uun3406/BLDC-TestBed-HardwareX/fig_system_overview.jpg

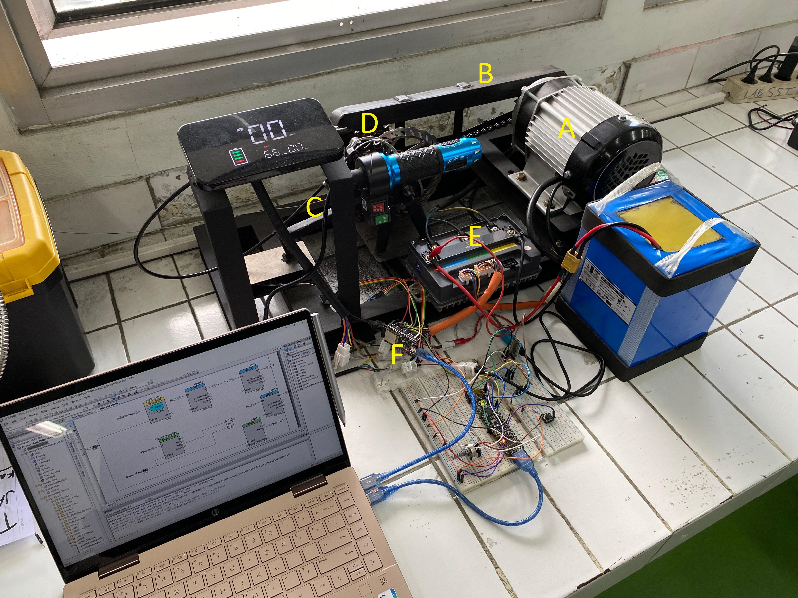
fig_system_overview.jpg
