uun3406/BLDC-TestBed-HardwareX/fig_mechanical_assembly.jpg

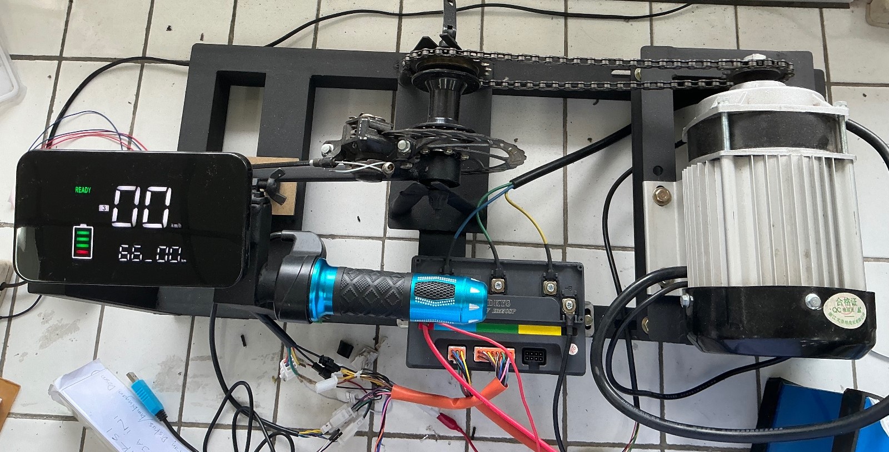
fig_mechanical_assembly.jpg
