uun3406/BLDC-TestBed-HardwareX/hardware/mechanical/frame_dimensions.pdf

# Frame Dimensions

Base frame for the BLDC motor test bed. The recommended base frame is 600 x 400 mm using 40 x 40 x 2 mm steel hollow sections. The motor mounting plate is 150 x 100 x 5 mm. The shaft center distance is 200 mm with a tolerance of +/- 0.5 mm.

This document summarizes the critical mechanical dimensions required for replication. Detailed assembly photos are available in hardware/mechanical/assembly_photos/.

Component | Dimension | Tolerance
Base frame | 600 x 400 mm | +/- 2 mm
Motor mounting plate | 150 x 100 x 5 mm | +/- 1 mm
Shaft center distance | 200 mm | +/- 0.5 mm
Brake disc runout | - | < 1 mm
