uun3406/BLDC-TestBed-HardwareX/hardware/mechanical/torque_arm_dimensions.pdf

# Torque Arm Dimensions

The torque arm is used to transfer floating-caliper reaction force to the load cell. The calibrated effective lever arm length is 100.0 mm. The arm is inclined at 40 degrees relative to the horizontal to accommodate the brake caliper geometry. Torque is calculated as T = F x L x cos(40 deg).

Parameter | Value | Tolerance/Note
Lever arm length | 100.0 mm | +/- 0.1 mm
Torque arm inclination | 40 degrees | +/- 1 degree
Load cell orientation | Vertical | Measure vertical reaction force
Torque equation | T = F x 0.1 x cos(40 deg) | T = F x 0.0766 m
