uun3406/BLDC-TestBed-HardwareX/hardware/wiring/esc_connector_pinout_table.pdf

# ESC Connector Pinout Reference Table

This table was redrawn from the supplied ESC connector image to improve readability. Verify row 5 of the 2 x 8 connector against the original ESC manual if exact wording is required.

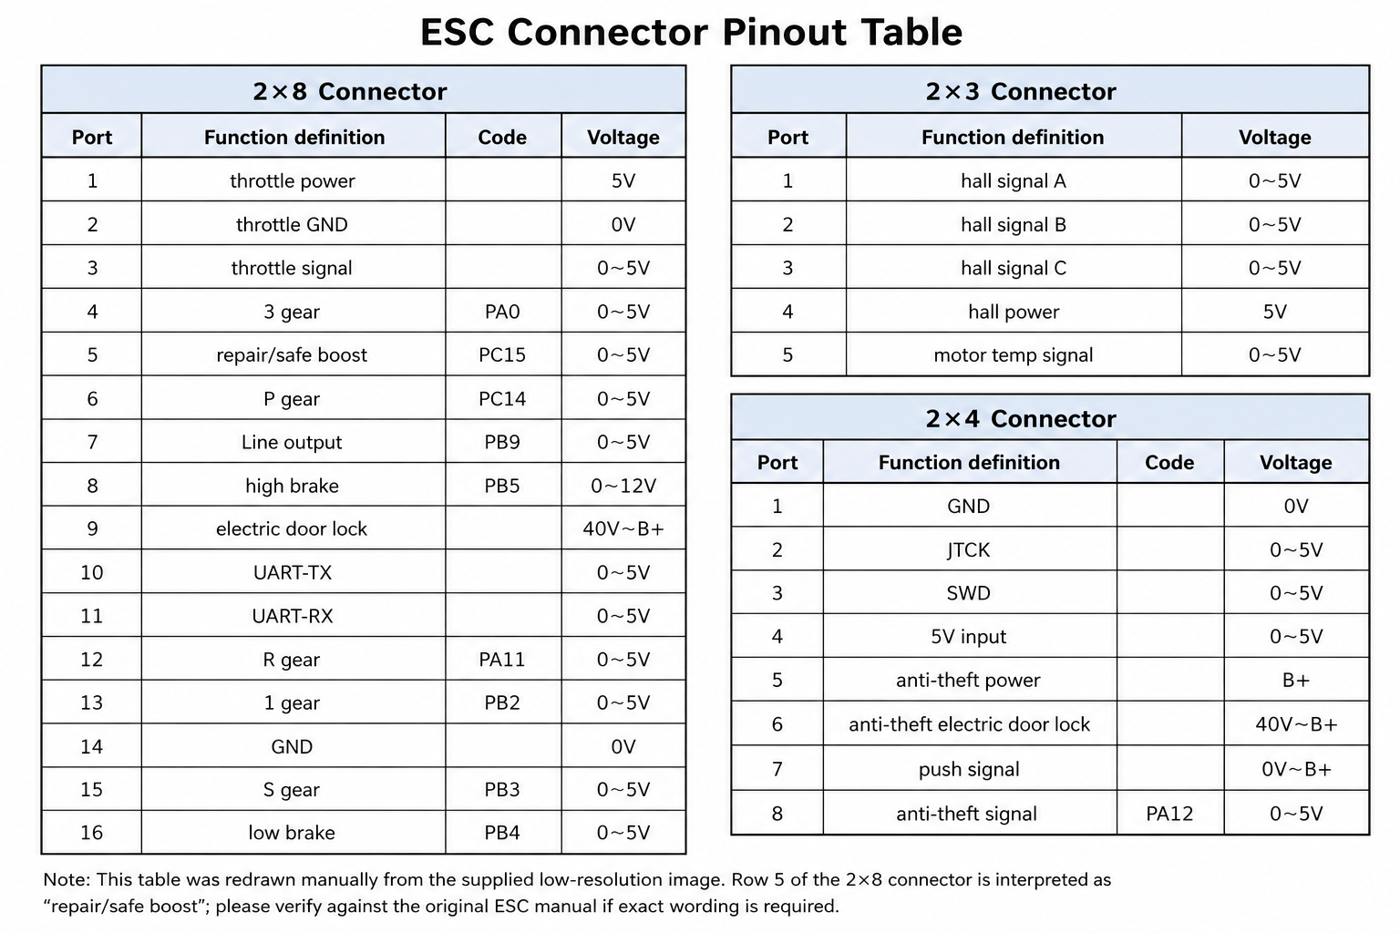
[picture p3: figure]
