uun3406/BLDC-TestBed-HardwareX/fig_floating_caliper.jpg

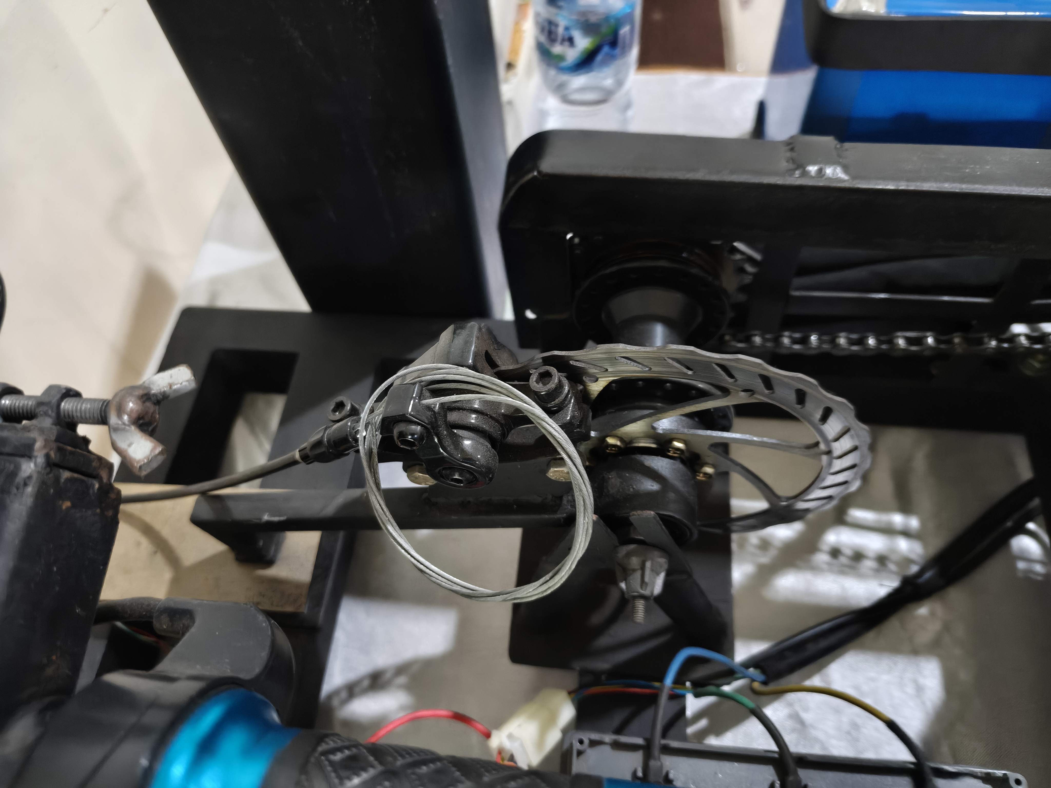
fig_floating_caliper.jpg
