uun3406/BLDC-TestBed-HardwareX/hardware/mechanical/assembly_photos/braking mechanics1.jpeg

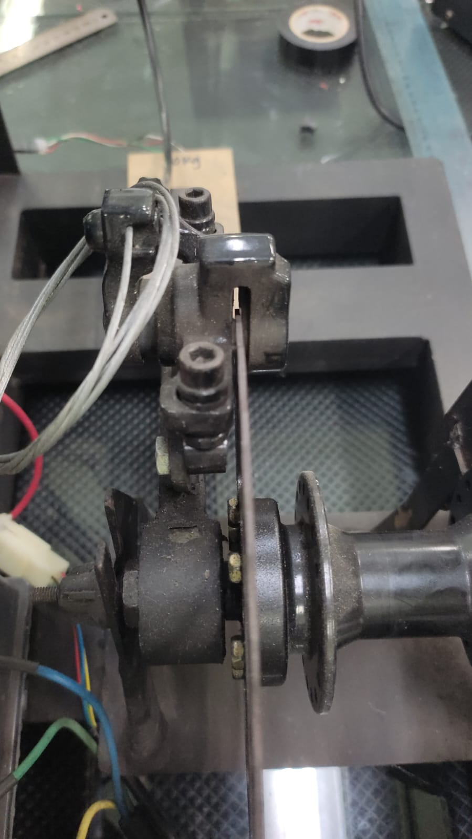
hardware/mechanical/assembly_photos/braking mechanics1.jpeg
