uun3406/BLDC-TestBed-HardwareX/hardware/mechanical/assembly_photos/braking mechanics2.jpeg

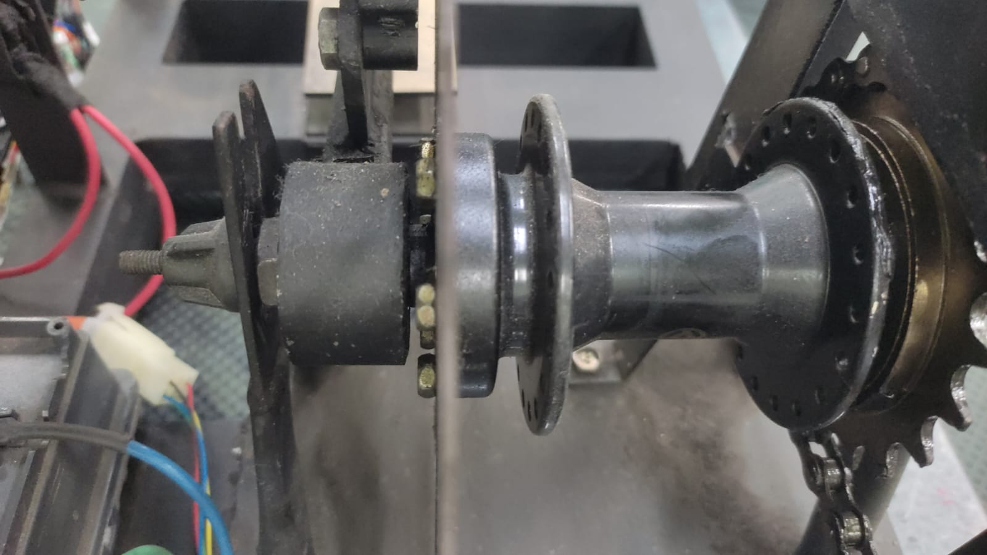
hardware/mechanical/assembly_photos/braking mechanics2.jpeg
