uun3406/BLDC-TestBed-HardwareX/hardware/mechanical/floating_caliper_photos/floating_caliper_mechanism.jpg

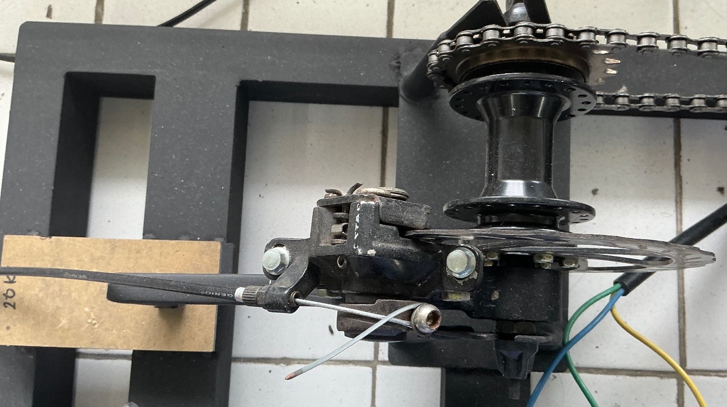
hardware/mechanical/floating_caliper_photos/floating_caliper_mechanism.jpg
