uun3406/BLDC-TestBed-HardwareX/hardware/mechanical/torque_arm_photo.jpg

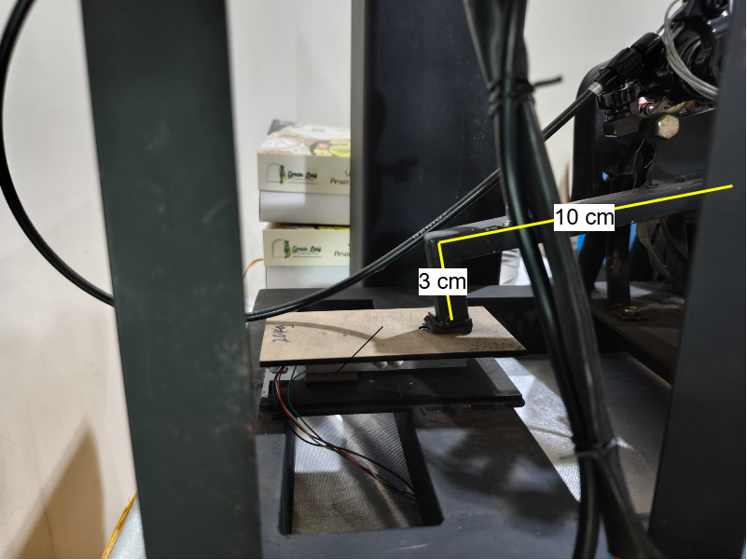
hardware/mechanical/torque_arm_photo.jpg
