uun3406/BLDC-TestBed-HardwareX/hardware/safety/emergency_stop_diagram.png

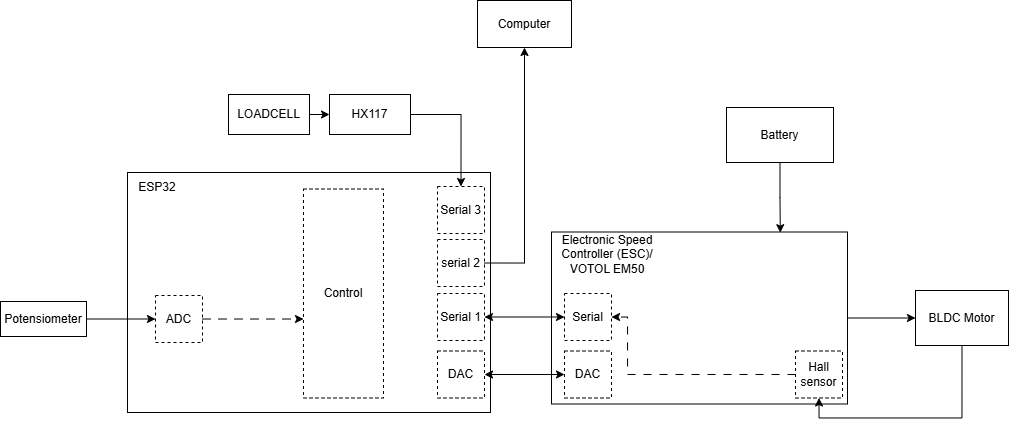
hardware/safety/emergency_stop_diagram.png
