uun3406/BLDC-TestBed-HardwareX/fig_bom_A_motor.jpg

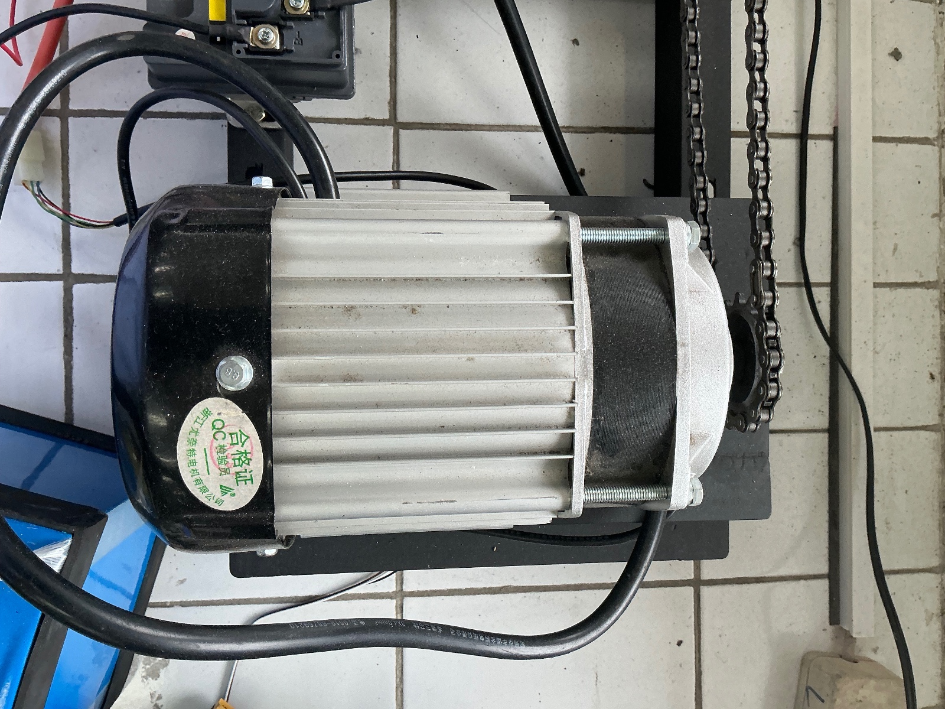
fig_bom_A_motor.jpg
