uun3406/BLDC-TestBed-HardwareX/fig_bom_B_esc.jpg

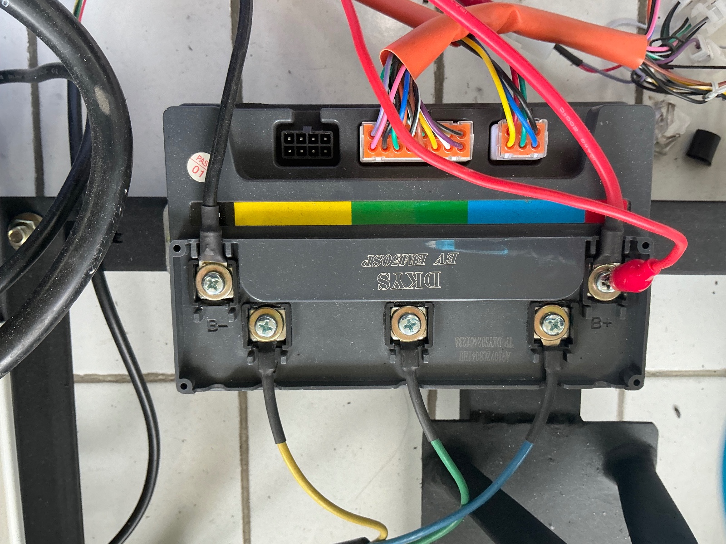
fig_bom_B_esc.jpg
