uun3406/BLDC-TestBed-HardwareX/fig_bom_C_esp32.jpg

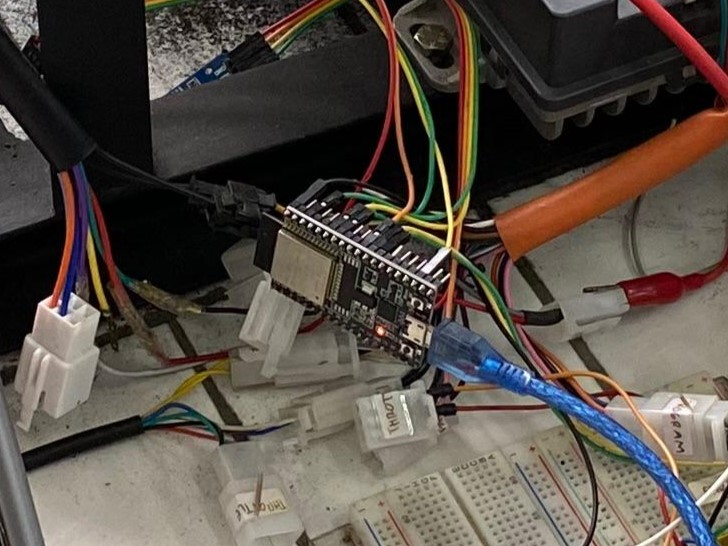
fig_bom_C_esp32.jpg
