uun3406/BLDC-TestBed-HardwareX/hardware/safety/pre_operation_checklist.pdf

# Pre-operation Checklist

Complete this checklist before every test session.

Check | Procedure | Acceptance
Mechanical fasteners | Torque check all bolts | No movement
Electrical insulation | Continuity test, 500 V megger | > 1 Mohm
Rotational freedom | Manual shaft rotation | Smooth, no binding
Chain guard | Verify complete installation | Fully enclosed
Emergency stop | Button press | Power interruption
Ground continuity | Resistance to earth | < 1 ohm
Battery safety | Check for damage/swelling | No defects
Torque arm angle | Measure with digital protractor | 40 deg +/- 1 deg
