uun3406/BLDC-TestBed-HardwareX/fig_operation_overview.jpg

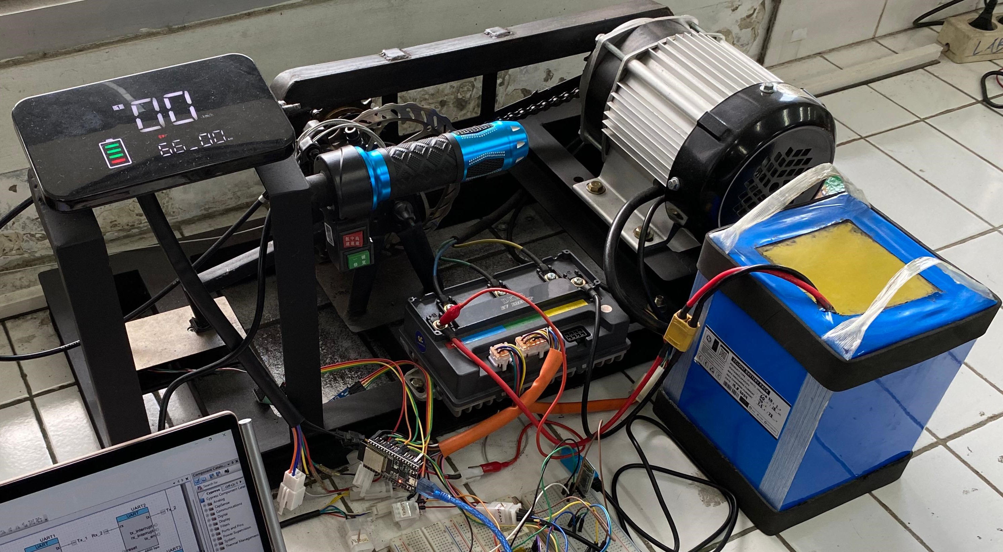
fig_operation_overview.jpg
