uun3406/BLDC-TestBed-HardwareX/hardware/mechanical/assembly_photos/BLDC Frame 1.jpeg

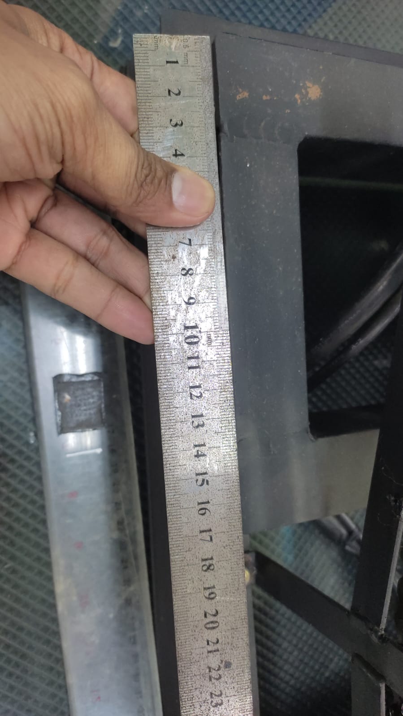
hardware/mechanical/assembly_photos/BLDC Frame 1.jpeg
