uun3406/BLDC-TestBed-HardwareX/hardware/mechanical/assembly_photos/brake adjuster thread.jpeg

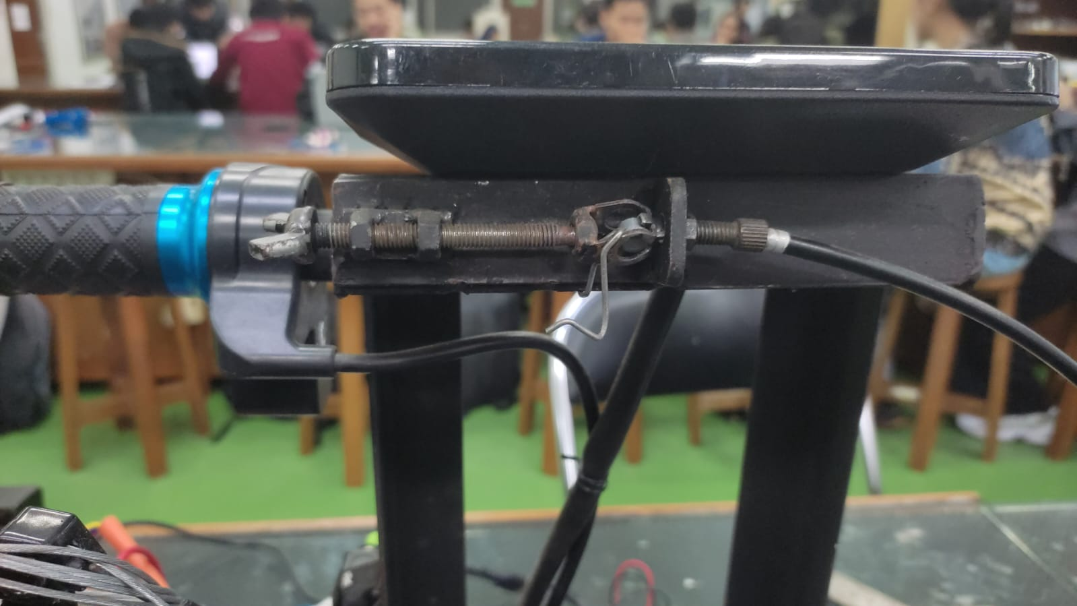
hardware/mechanical/assembly_photos/brake adjuster thread.jpeg
