uun3406/BLDC-TestBed-HardwareX/hardware/mechanical/assembly_photos/chain guard.jpeg

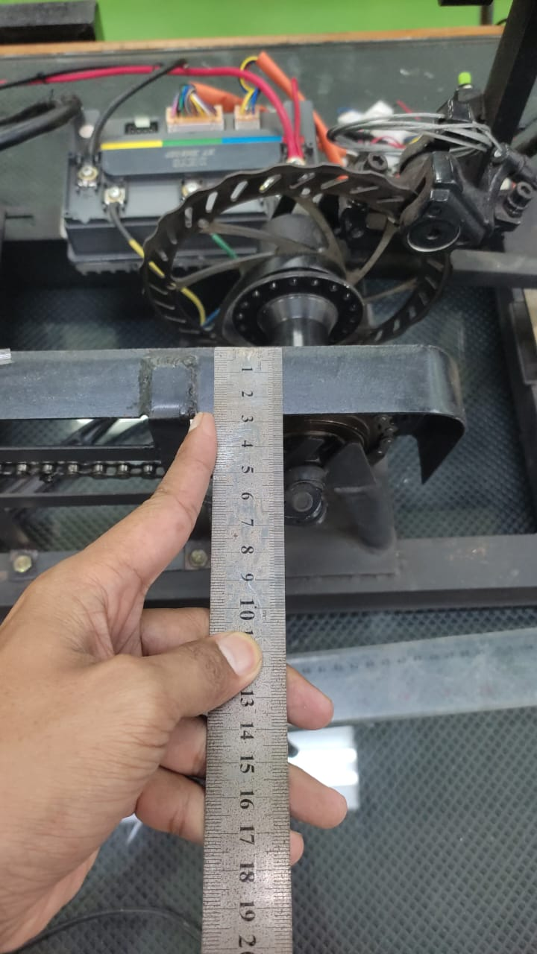
hardware/mechanical/assembly_photos/chain guard.jpeg
