uun3406/BLDC-TestBed-HardwareX/hardware/mechanical/assembly_photos/gear frame1.jpeg

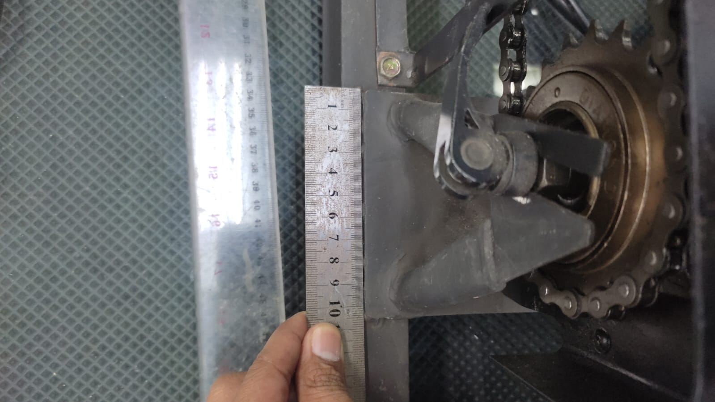
hardware/mechanical/assembly_photos/gear frame1.jpeg
