uun3406/BLDC-TestBed-HardwareX/hardware/mechanical/assembly_photos/gear frame2.jpeg

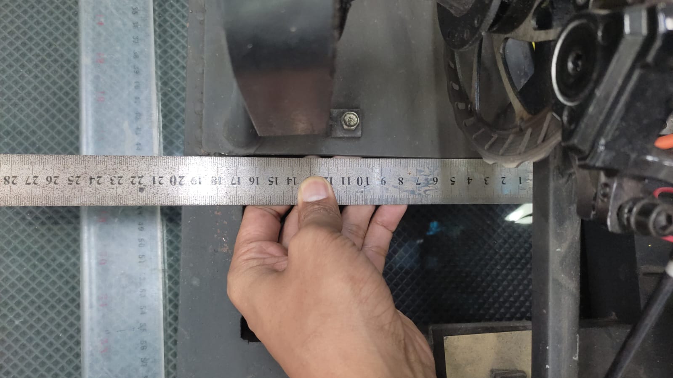
hardware/mechanical/assembly_photos/gear frame2.jpeg
