uun3406/BLDC-TestBed-HardwareX/hardware/mechanical/assembly_photos/Gear support1.jpeg

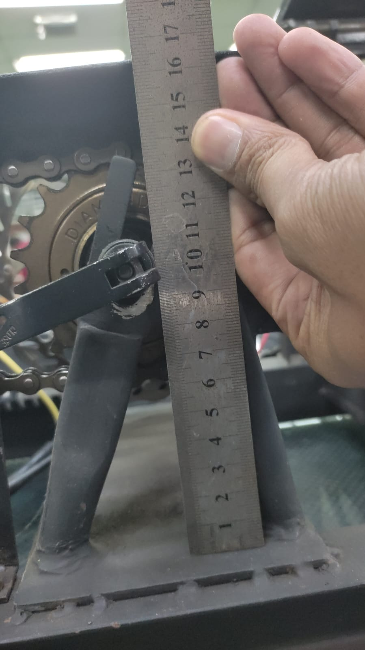
hardware/mechanical/assembly_photos/Gear support1.jpeg
