uun3406/BLDC-TestBed-HardwareX/hardware/mechanical/assembly_photos/Gear support 3.jpeg

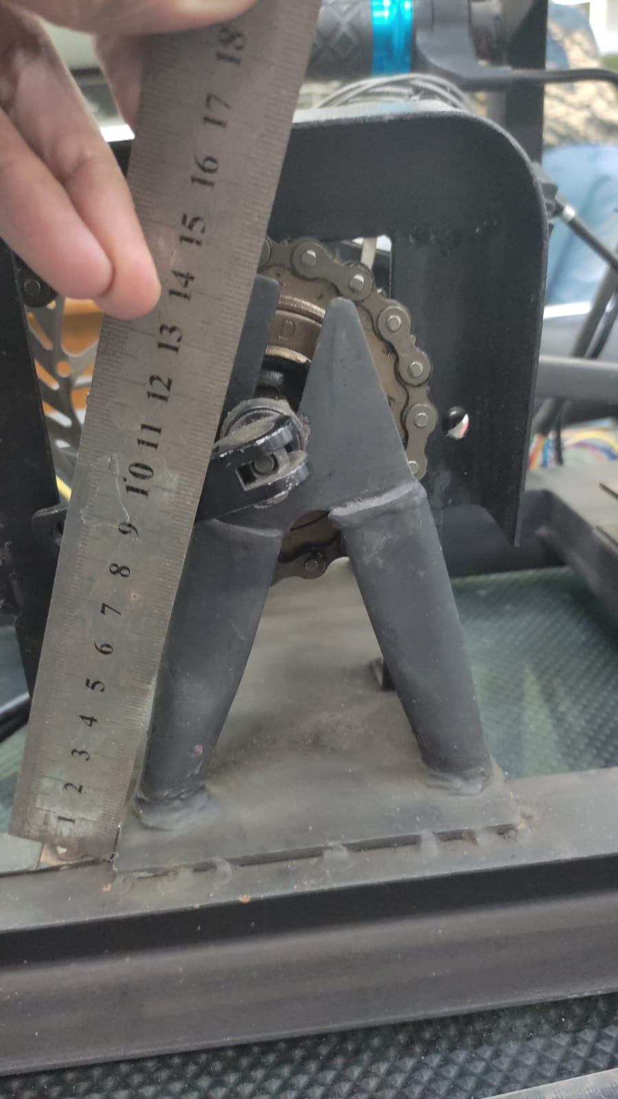
hardware/mechanical/assembly_photos/Gear support 3.jpeg
