uun3406/BLDC-TestBed-HardwareX/hardware/mechanical/assembly_photos/LCD stand2.jpeg

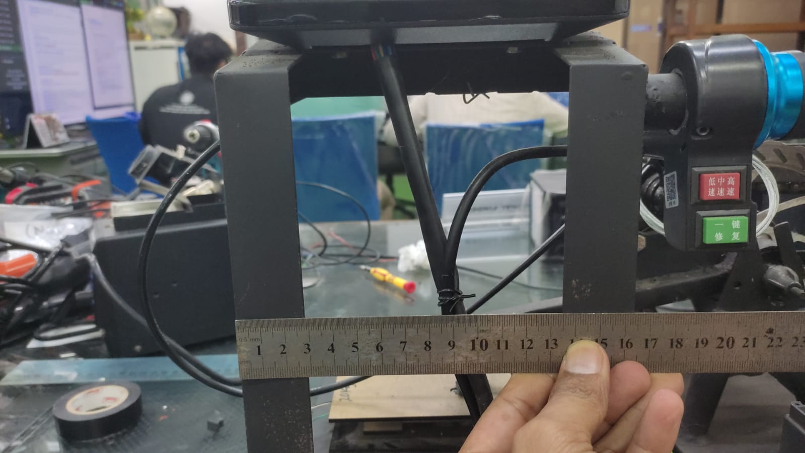
hardware/mechanical/assembly_photos/LCD stand2.jpeg
