uun3406/BLDC-TestBed-HardwareX/hardware/mechanical/assembly_photos/load cell position.jpeg

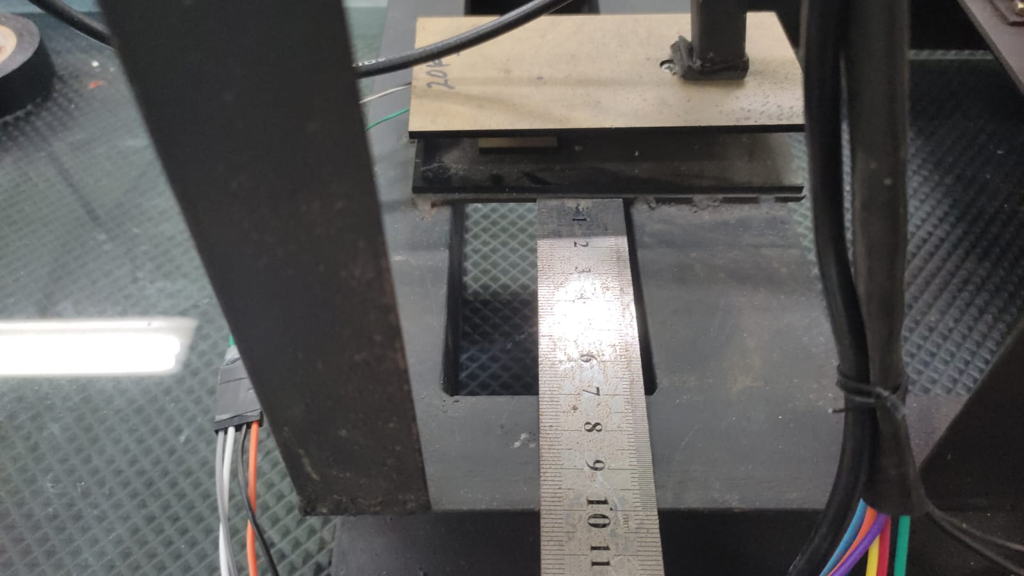
hardware/mechanical/assembly_photos/load cell position.jpeg
