uun3406/BLDC-TestBed-HardwareX/hardware/mechanical/assembly_photos/Loadcell frame 1.jpeg

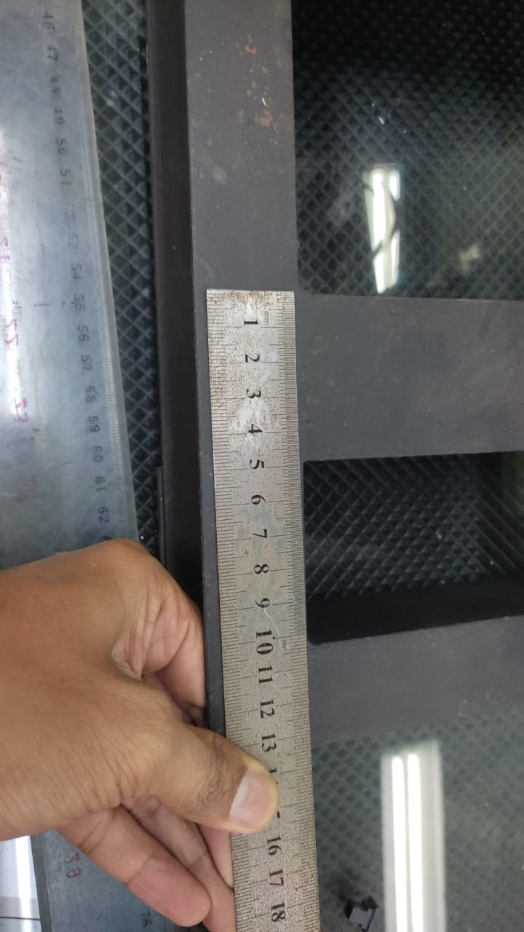
hardware/mechanical/assembly_photos/Loadcell frame 1.jpeg
