uun3406/BLDC-TestBed-HardwareX/hardware/mechanical/assembly_photos/Loadcell frame.jpeg

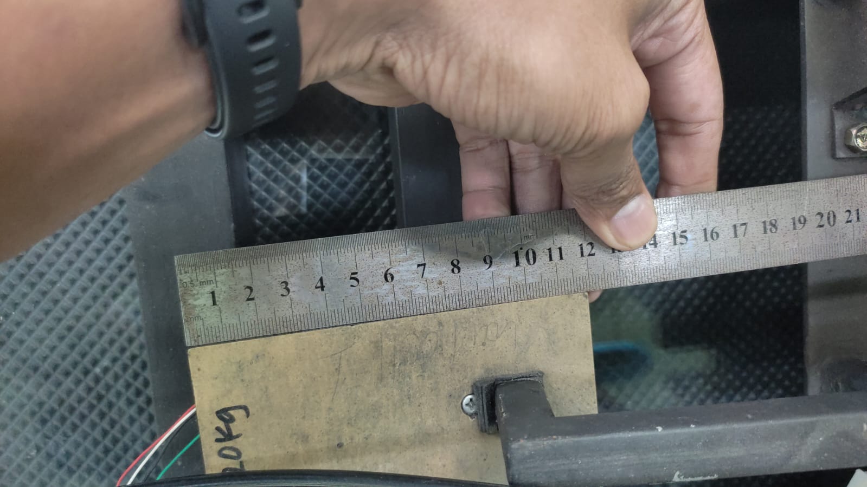
hardware/mechanical/assembly_photos/Loadcell frame.jpeg
