uun3406/BLDC-TestBed-HardwareX/hardware/mechanical/assembly_photos/Main Frame 1A Zoom.jpeg

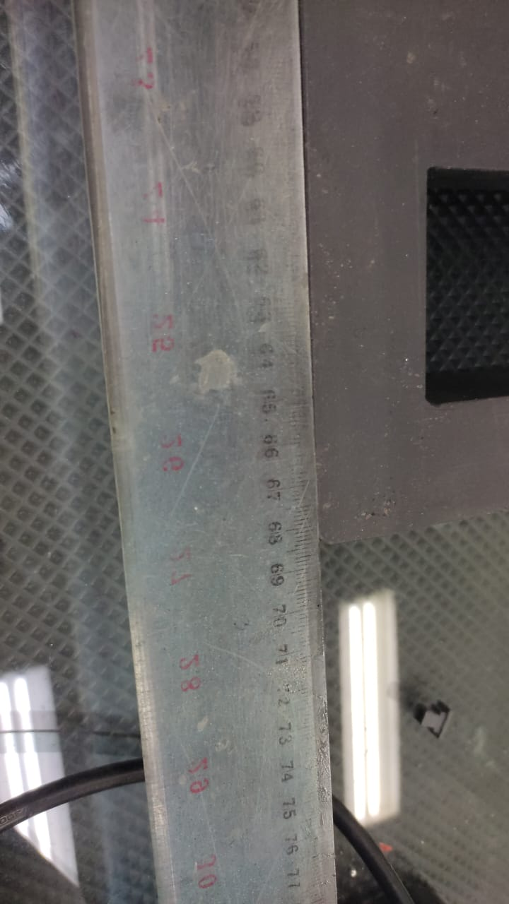
hardware/mechanical/assembly_photos/Main Frame 1A Zoom.jpeg
