uun3406/BLDC-TestBed-HardwareX/hardware/mechanical/assembly_photos/Main Frame 3.jpeg

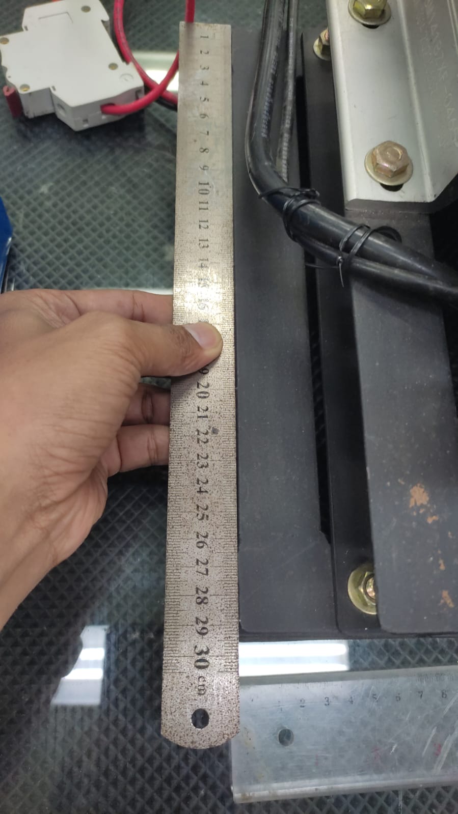
hardware/mechanical/assembly_photos/Main Frame 3.jpeg
