uun3406/BLDC-TestBed-HardwareX/media/photos/assembly/01_cutting_steel_sections.jpg

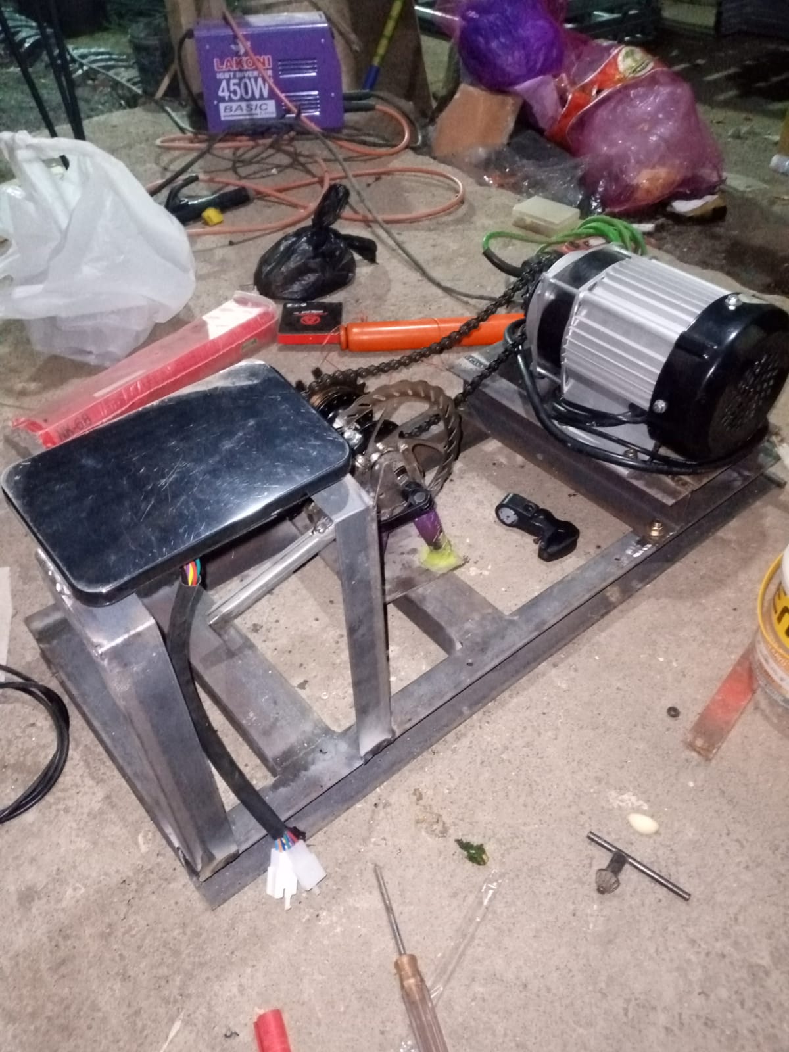
media/photos/assembly/01_cutting_steel_sections.jpg
