uun3406/BLDC-TestBed-HardwareX/media/photos/assembly/02_tack_welding_alignment.jpg

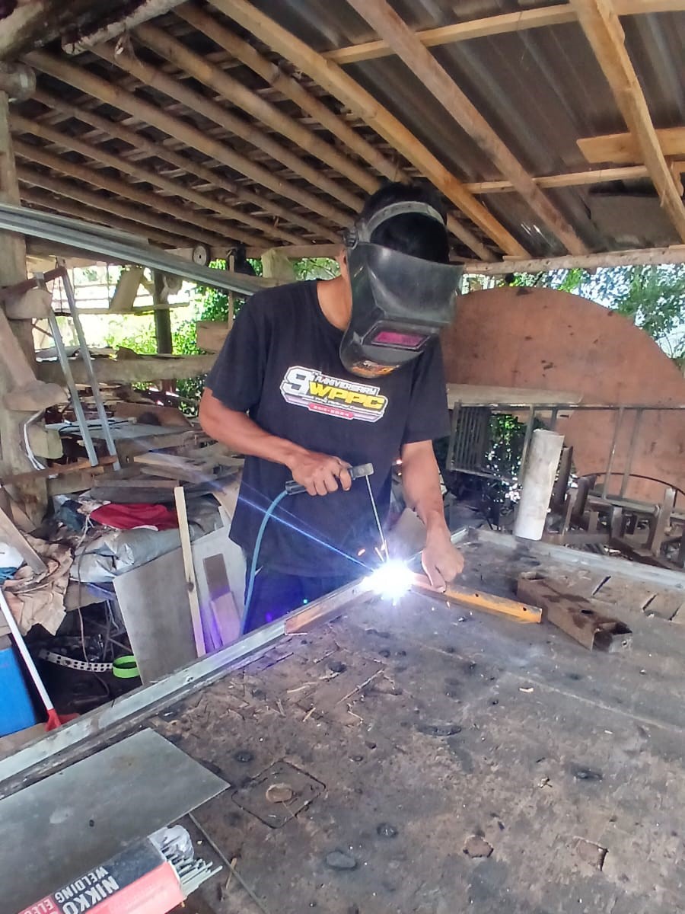
media/photos/assembly/02_tack_welding_alignment.jpg
