uun3406/BLDC-TestBed-HardwareX/media/photos/assembly/03_full_welding_frame.jpg

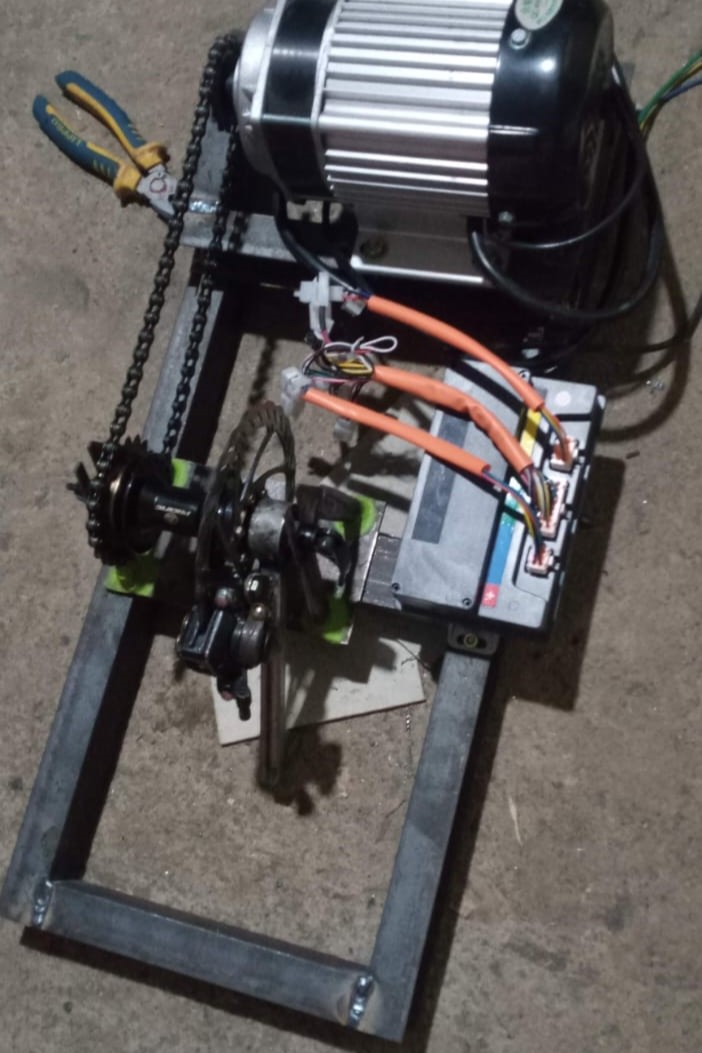
media/photos/assembly/03_full_welding_frame.jpg
