uun3406/BLDC-TestBed-HardwareX/media/photos/assembly/04_surface_finishing_mounting.jpg

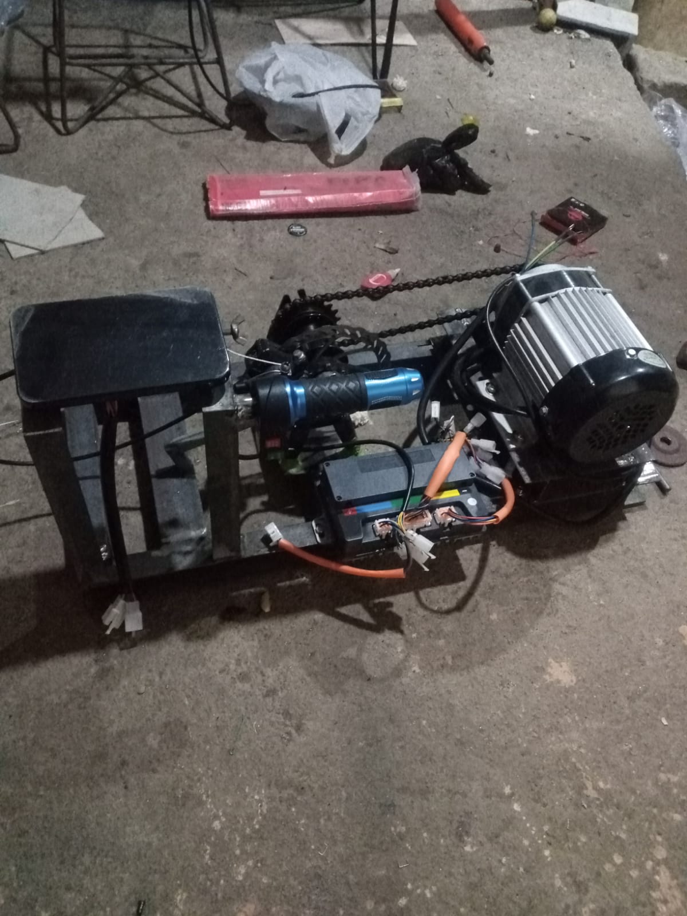
media/photos/assembly/04_surface_finishing_mounting.jpg
