uun3406/BLDC-TestBed-HardwareX/media/photos/operation/IMG_0211.jpeg

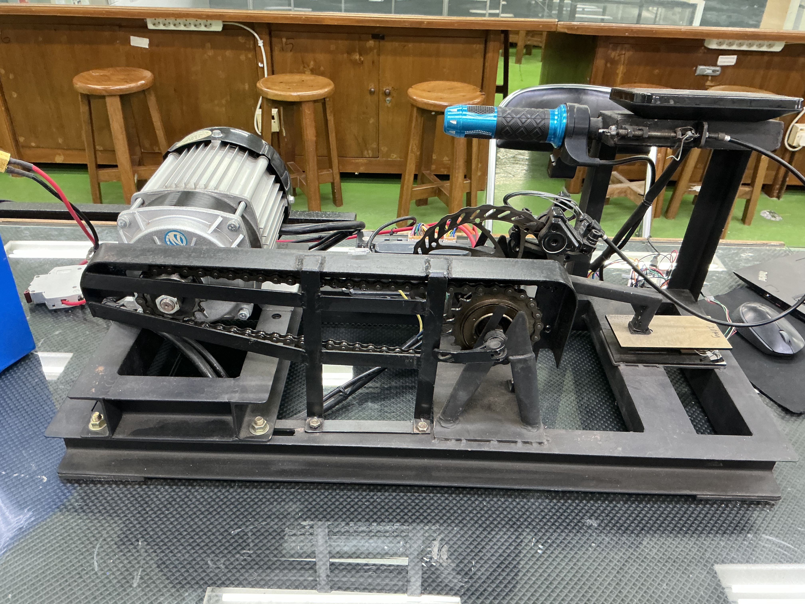
media/photos/operation/IMG_0211.jpeg
