uun3406/BLDC-TestBed-HardwareX/media/photos/operation/IMG_0212.jpeg

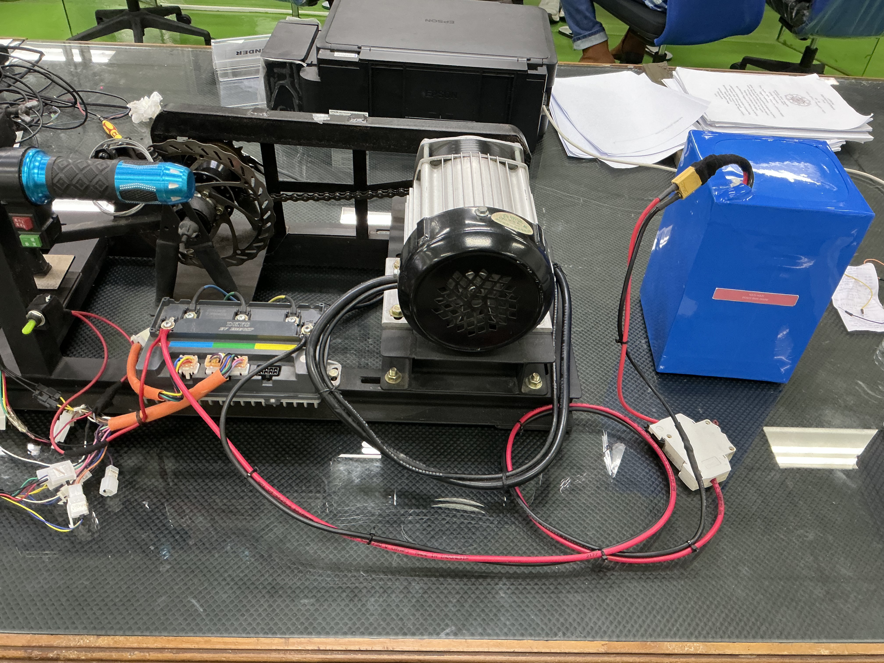
media/photos/operation/IMG_0212.jpeg
