uun3406/BLDC-TestBed-HardwareX/media/photos/operation/IMG_0213.jpeg

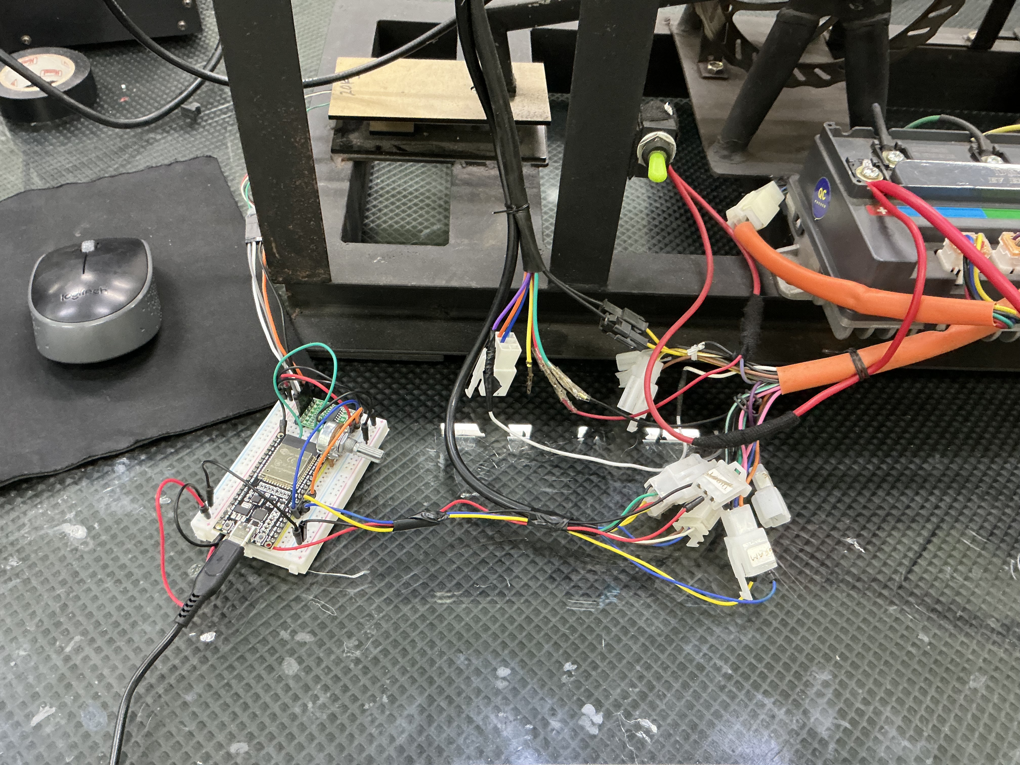
media/photos/operation/IMG_0213.jpeg
