uun3406/BLDC-TestBed-HardwareX/media/photos/operation/IMG_0215.jpeg

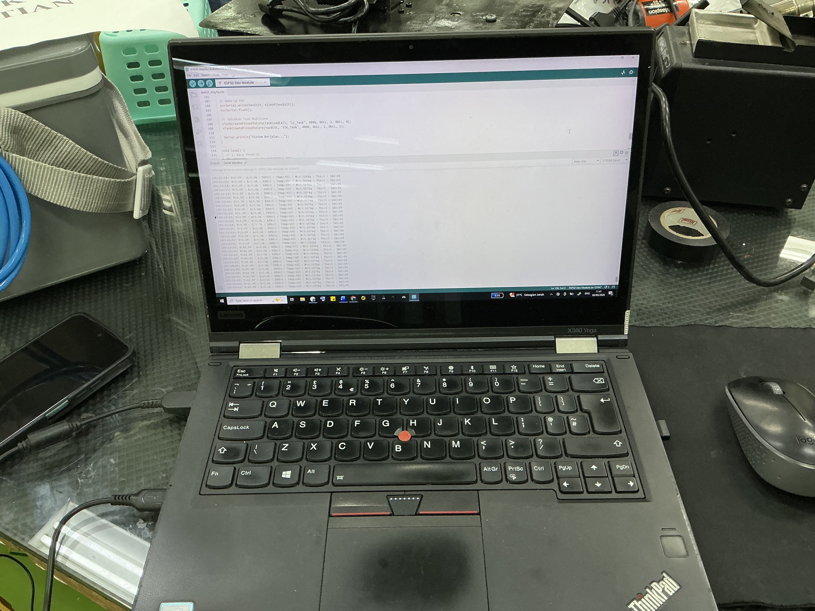
media/photos/operation/IMG_0215.jpeg
