uun3406/BLDC-TestBed-HardwareX/media/photos/operation/IMG_0216.jpeg

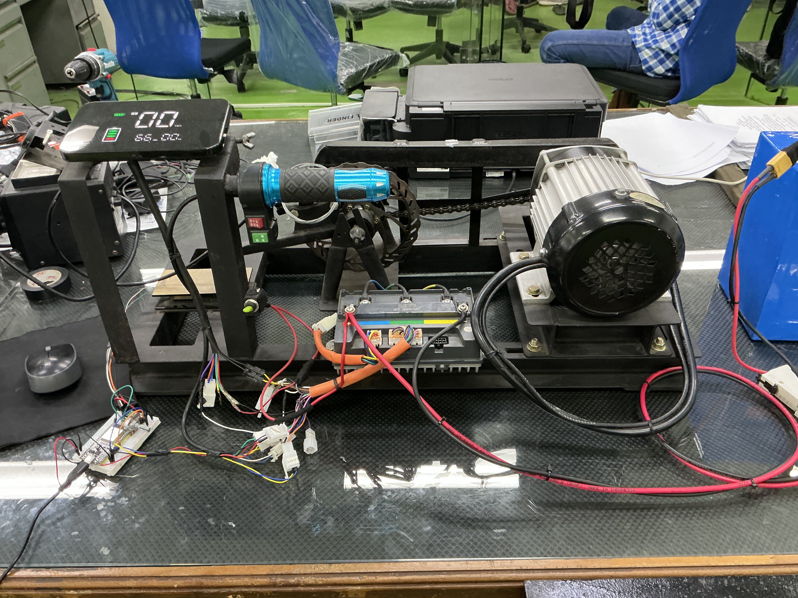
media/photos/operation/IMG_0216.jpeg
