uun3406/BLDC-TestBed-HardwareX/media/photos/operation/normal_operation.jpg

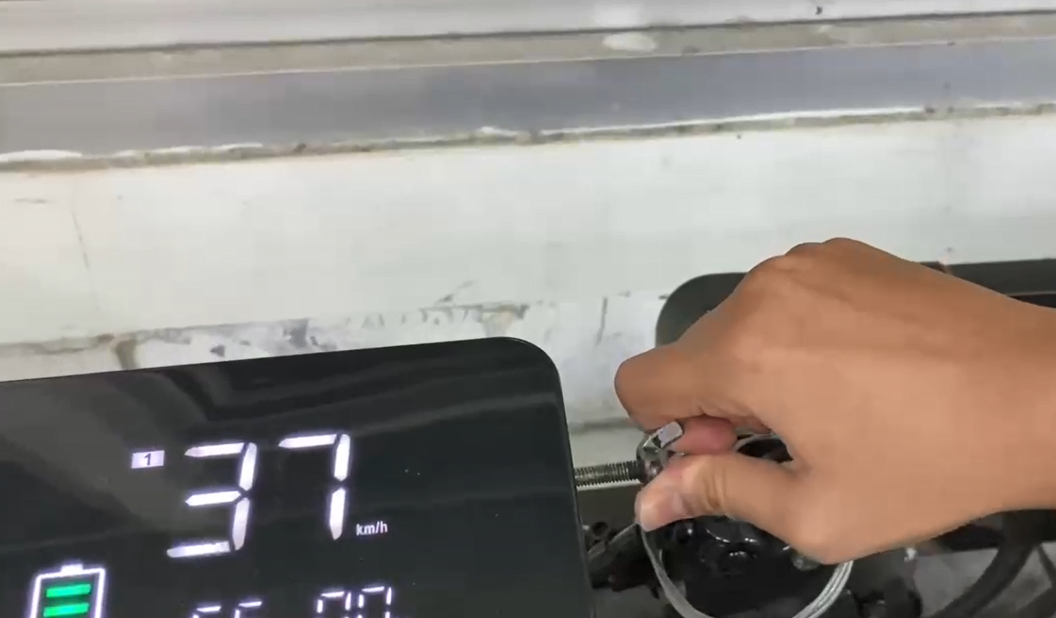
media/photos/operation/normal_operation.jpg
