uun3406/BLDC-TestBed-HardwareX/media/photos/wiring/wiring_diagram_clean.png

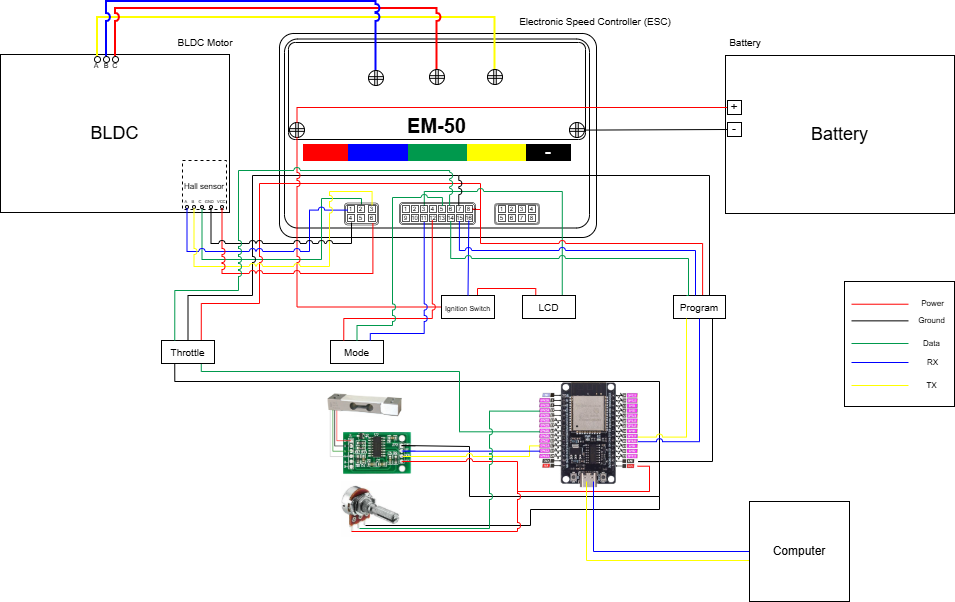
media/photos/wiring/wiring_diagram_clean.png
