uun3406/BLDC-TestBed-HardwareX/data/processed/model_vs_experiment.csv

time_s | model_speed_rpm | experimental_speed_rpm | error_rpm
0.0 | 0.0 | 0.0 | 0.0
0.1 | 210.32 | 212.68 | 2.36
0.2 | 398.53 | 403.12 | 4.6
0.3 | 566.94 | 573.53 | 6.59
0.4 | 717.64 | 725.88 | 8.24
0.5 | 852.49 | 861.95 | 9.46
0.6 | 973.17 | 983.34 | 10.17
0.7 | 1081.15 | 1091.5 | 10.35
0.8 | 1177.78 | 1187.76 | 9.99
0.9 | 1264.24 | 1273.34 | 9.1
1.0 | 1341.61 | 1349.34 | 7.73
1.1 | 1410.85 | 1416.8 | 5.95
1.2 | 1472.81 | 1476.66 | 3.86
1.3 | 1528.25 | 1529.81 | 1.56
1.4 | 1577.86 | 1577.04 | -0.81
1.5 | 1622.25 | 1619.1 | -3.14
1.6 | 1661.97 | 1656.66 | -5.31
1.7 | 1697.52 | 1690.32 | -7.2
1.8 | 1729.33 | 1720.62 | -8.71
1.9 | 1757.79 | 1748.03 | -9.76
2.0 | 1783.26 | 1772.97 | -10.29
2.1 | 1806.06 | 1795.77 | -10.29
2.2 | 1826.45 | 1816.71 | -9.74
2.3 | 1844.7 | 1836.02 | -8.68
2.4 | 1861.03 | 1853.87 | -7.16
2.5 | 1875.65 | 1870.38 | -5.27
2.6 | 1888.72 | 1885.63 | -3.09
2.7 | 1900.43 | 1899.67 | -0.76
2.8 | 1910.9 | 1912.52 | 1.62
2.9 | 1920.27 | 1924.18 | 3.91
3.0 | 1928.65 | 1934.64 | 5.99
3.1 | 1936.16 | 1943.92 | 7.76
3.2 | 1942.87 | 1951.99 | 9.12
3.3 | 1948.88 | 1958.88 | 10.0
3.4 | 1954.25 | 1964.61 | 10.35
3.5 | 1959.06 | 1969.23 | 10.16
3.6 | 1963.37 | 1972.8 | 9.43
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
