uun3406/BLDC-TestBed-HardwareX/media/photos/calibration/torque_calibration.jpg

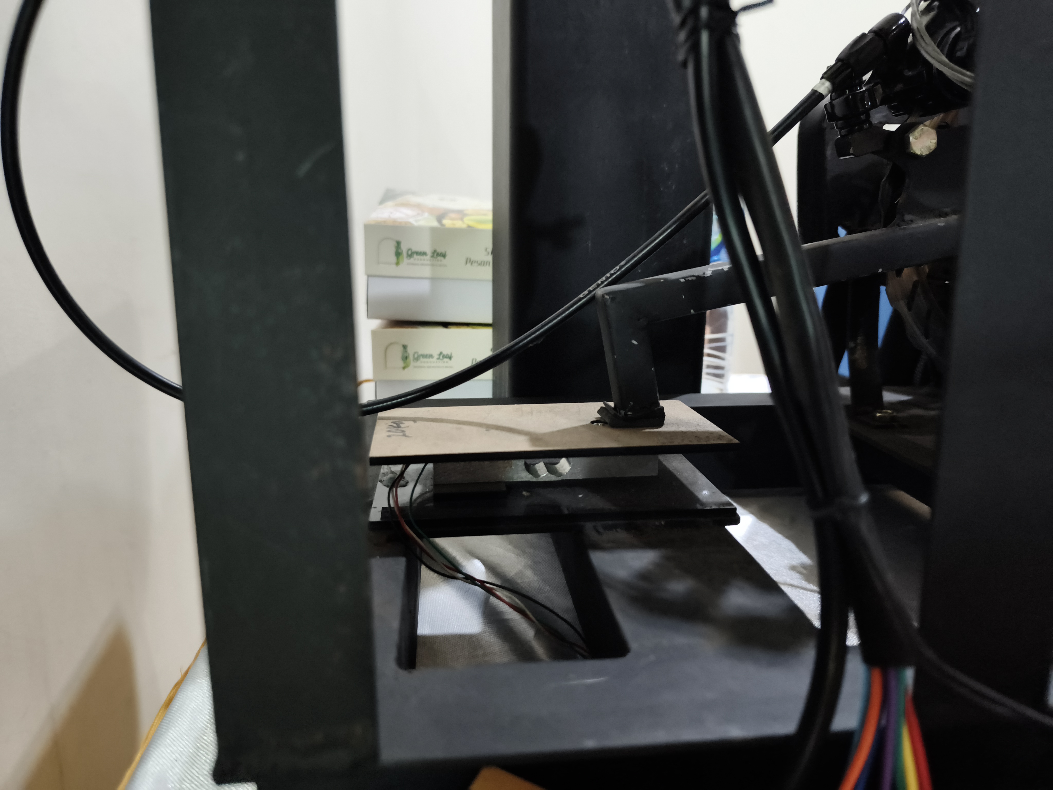
media/photos/calibration/torque_calibration.jpg
