uun3406/BLDC-TestBed-HardwareX/media/photos/calibration/torque_verification.jpg

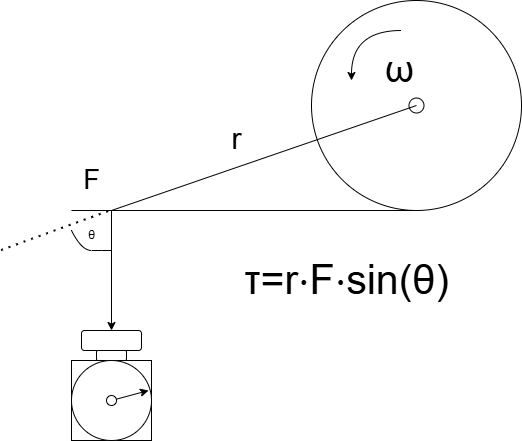
media/photos/calibration/torque_verification.jpg
