uun3406/BLDC-TestBed-HardwareX/media/photos/calibration/validation_setup.jpg

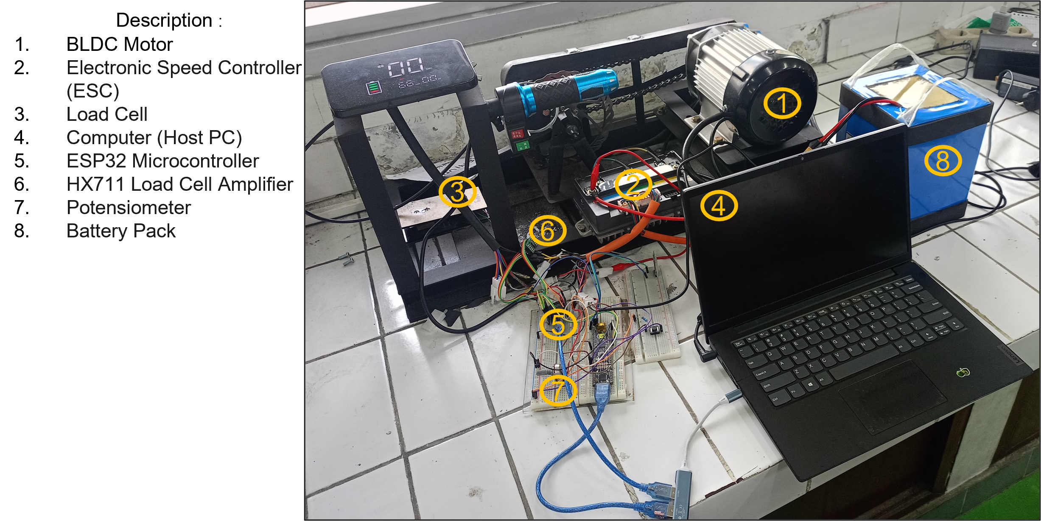
media/photos/calibration/validation_setup.jpg
